donegal06/mx5-na8-ecu/boards/hellen64_NA6_94-d/board/hellen64_NA6_94-d.png

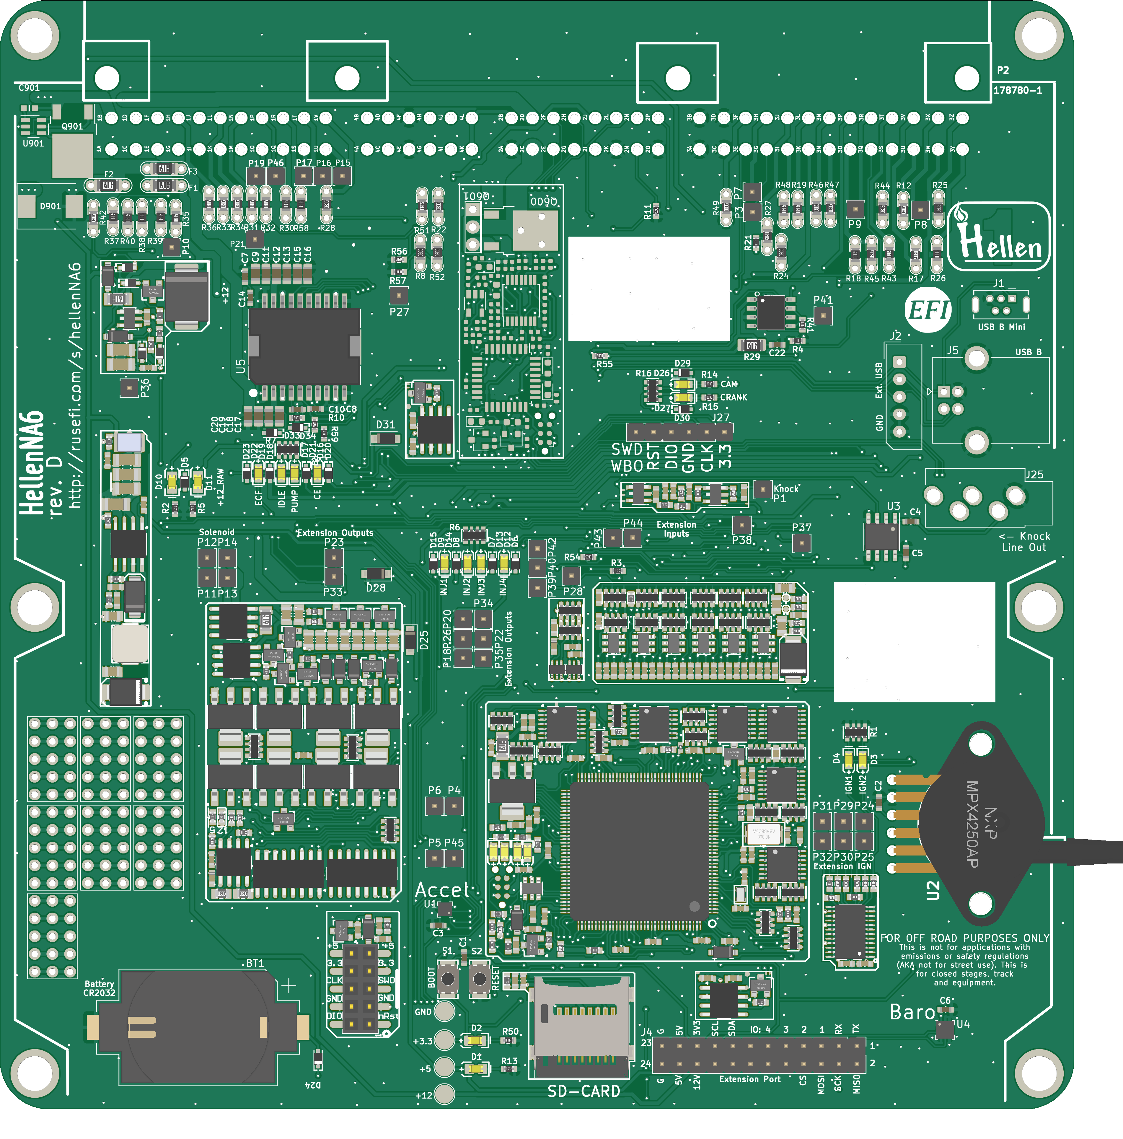
boards/hellen64_NA6_94-d/board/hellen64_NA6_94-d.png
