donegal06/mx5-na8-ecu/boards/hellen64_NA6_94-d/board/misc/hellen64_NA6_94-d-top.png

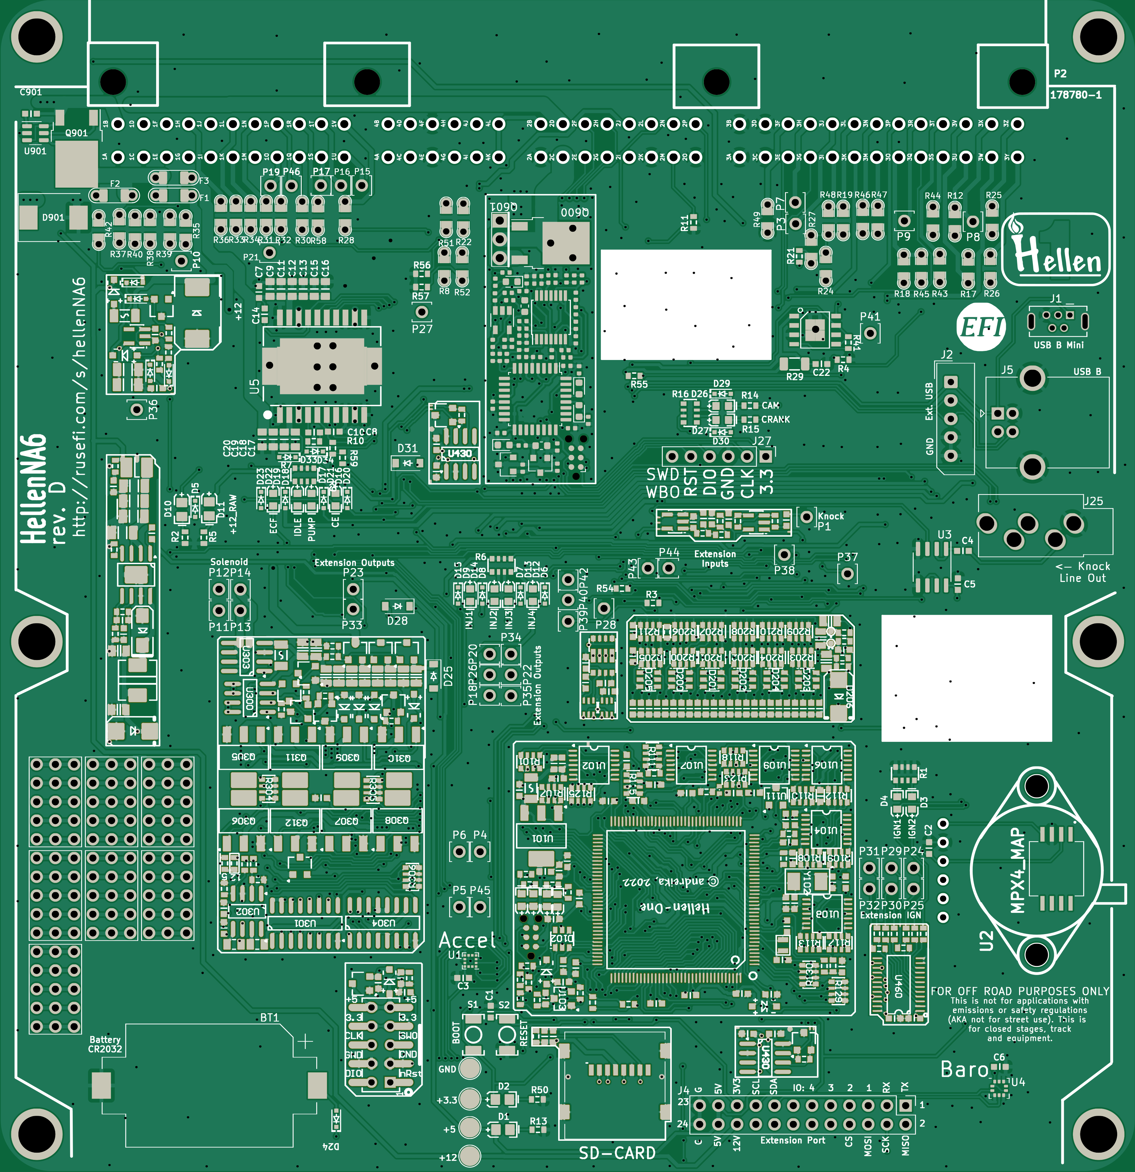
boards/hellen64_NA6_94-d/board/misc/hellen64_NA6_94-d-top.png
