donegal06/mx5-na8-ecu/tools/1b_protection_placement.png

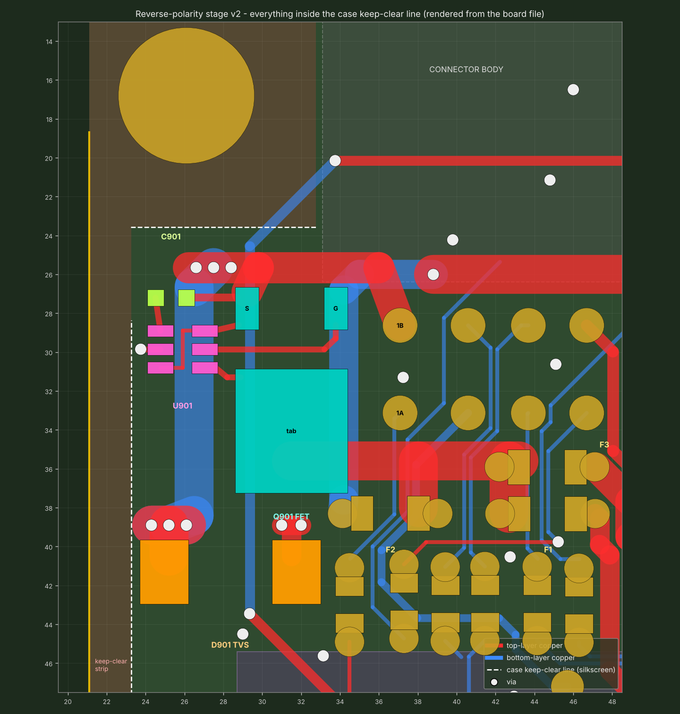
tools/1b_protection_placement.png
