donegal06/mx5-na8-ecu/bom_replace_hellen64_NA6_94-d.csv

# remove the jumper connection from VCC_PP1 to +5V: we need +12v power supply for push-pull outputs.
R309,
# remove +5V pull-ups from SPI1, because we use it with +3.3v accelerometer
R103,
R105,
# remove jumper resistor connecting BOOT1 with A22 input line, because we use STM32F4
R131,
# STM32
U105,"STM32F407ZGT6","LQFP144","C19156"
# DC-DC Inductor
L421,"MWSA0503S-100MT","SMD-5.2x5.4x2.8","C408412"
L420,"LBC3225T2R2MR","1210","C223413"
# LMR14020->LMR16030 (MX-5 fork): 60 V input rating so a load dump that gets past
# the TVS (clamp up to 53.3 V) does not exceed the buck's VIN rating.
# Pin-compatible SO-8 PowerPAD (BOOT,VIN,EN,RT,FB,SS,GND,SW), same 0.75 V FB
# reference (68k/12k divider still gives 5.0 V), same RT curve (10k = ~2.2 MHz).
# Above ~25 V input it pulse-skips (90 ns min on-time) - acceptable for transients.
U420,"LMR16030SDDA","SOP8","C882387"
# Catch diode SS34 (40 V) -> SS310 (100 V), required with the 60 V buck
D420,"SS310","SMA","C116705"
# Input TVS SMCJ30A -> SMCJ33A: VBR min 36.7 V, so it no longer conducts against an
# alternator clamped at 35 V (ISO 16750-2 pulse 5b); simulation showed SMCJ30A at
# its 33.3 V minimum absorbing ~11 J there. Vc max 53.3 V @ 28 A, within the 60 V buck.
D418,"SMCJ33A","SMC","C438109"
# Ignition outputs to the stock NA igniter (1G via R467 = IGN1, 1H via R464 = IGN2):
# 10 ohm -> 330 ohm (MX-5 fork). Matches the proven MegaSquirt drive for factory Miata
# igniters (270-330 ohm series) and limits a short to +14 V to ~39 mA, inside the
# SN74LVC4245's ~50 mA output limit. In a sustained short the 0603 overheats and opens
# first, protecting the buffer. IGN3-8 stay 10 ohm for future smart coils.
R467,"330","R0603","C23138"
R464,"330","R0603","C23138"
# CAN termination (MX-5 fork): the MCU CAN module and the wideband CAN module
# each carry a 120R terminator on the same bus, so the board measures 60R.
# Drop one so the ECU end is 120R; the last gauge pod on the bus carries the
# other 120R. Bus: ECU 1D/1F -> pod 1 -> pod 2 (terminated).
R430_2,
# trigger schmidt buffer
U490,"SN74LVC2G17DCKR","SOT-363","C50714"
U491,"SN74LVC2G17DCKR","SOT-363","C50714"
#fuses
# Logic-supply PTC (0.5 A hold, 24 V) -> 0 ohm link (MX-5 fork): the logic feed draws
# ~0.52 A at a 6.5 V crank, above the PTC's derated hold current, so a long hot crank
# could reset the ECU. Overcurrent protection stays with board fuses F1-F3 (5 A).
F410,"0R","F1206","C17888"
F300,"nSMD050-24V","F1206","C70076"
F1,"Fuse-5A-1206","F1206","C553924"
F2,"Fuse-5A-1206","F1206","C553924"
F3,"Fuse-5A-1206","F1206","C553924"
"R29,F101","nSMD035-16V","SMD1206","C70072"
#INJ low-side
Q305,"ZXMS6005SGTA","SOT-223","C174042"
Q306,"ZXMS6005SGTA","SOT-223","C174042"
Q307,"ZXMS6005SGTA","SOT-223","C174042"
Q308,"ZXMS6005SGTA","SOT-223","C174042"
Q309,"ZXMS6005SGTA","SOT-223","C174042"
Q310,"ZXMS6005SGTA","SOT-223","C174042"
Q311,"ZXMS6005SGTA","SOT-223","C174042"
Q312,"ZXMS6005SGTA","SOT-223","C174042"
#power distribution
U103,"AP2331W-7","SOT-23","C460346"
U480,"AP2331W-7","SOT-23","C460346"
#wbo opamp
U601,"GS8551-TR","TSOT23-5","C157715"
#non-JLC componentts
#WBO heater low-side (MX-5 fork: fitted, so the on-board wideband works)
Q600,"BTS3028SDL","DPAK","C2150071"
Q600_2,
#WBO low-side
Q601,
Q601_2,
#WBO STM32 (MX-5 fork: fitted; needs one-time SWD flash via J27)
U602,"STM32F042K6Tx","LQFP32","C69216"
U602_2,
#pressure sensor
U4,
#MX-5 fork: leave the optional high-side / push-pull / solenoid H-bridge outputs unfitted.
# They only reach solder pads P11-P14, P18, P22, P23, P26, P27 (not the ECU connector), nothing
# in the NA8 plan uses them, and RZ7899 / PJM2319PSA are not orderable through JLC right now.
U300,
U303,
Q300,
Q301,
Q302,
Q303,
Q304,
Q313,
Q314,
#MX-5 fork: in-stock equivalents chosen on the JLC parts page (originals out of stock)
C603,"33n","C0402","C106862"
D3,"LED-BLUE-0603","LED-0603","C138541"
D4,"LED-BLUE-0603","LED-0603","C138541"
D105,"LED-BLUE-0603","LED-0603","C138541"
D602,"LED-BLUE-0603","LED-0603","C138541"
D104,"LED-GREEN-0603","LED-0603","C19273151"
D601,"LED-GREEN-0603","LED-0603","C19273151"
D106,"LED-YELLOW-0603","LED-0603","C165981"
C227,"2.2u","C0805","C125847"
C228,"2.2u","C0805","C125847"
C229,"2.2u","C0805","C125847"
#main ECU connector (MX-5 fork): through-hole, fitted by JLC so it needn't be hand-soldered
P2,"178780-1","178780-1","C5166246"
#include board_id_na6_94-d.csv
