donegal06/mx5-na8-ecu/boards/hellen64_NA6_94-d/frame/64_NA6_94-BOM.csv

Comment | Designator | Footprint | LCSC Part #
BATTERY_CR2032 | BT1 | BATTERY-2032 | C70377
100n | C1 | C0603 | C14663
100n | C2 | C0603 | C14663
100n | C3 | C0603 | C14663
10u | C4 | C0603 | C19702
100n | C5 | C0603 | C14663
100n | C6 | C0603 | C14663
100n | C7 | C0603 | C14663
6.8n | C8 | C0603 | C1631
10u | C9 | C0805 | C15850
10n | C10 | C0603 | C57112
10u | C11 | C0805 | C15850
10u | C12 | C0805 | C15850
10u | C13 | C0805 | C15850
220n | C14 | C0603 | C21120
10u | C15 | C0805 | C15850
10u | C16 | C0805 | C15850
10u | C17 | C0805 | C15850
10u | C18 | C0805 | C15850
10u | C19 | C0805 | C15850
10u | C20 | C0805 | C15850
1u | C22 | C0603 | C15849
100n | C901 | C0603 | C14663
LED-GREEN-0805 | D1 | LED-0805 | C2297
LED-GREEN-0805 | D2 | LED-0805 | C2297
LED-BLUE-0603 | D3 | LED-0603 | C72041
LED-BLUE-0603 | D4 | LED-0603 | C72041
1N4148WS | D5 | SOD-323 | C2128
LED-RED-0603 | D6 | LED-0603 | C2286
LED-RED-0603 | D7 | LED-0603 | C2286
LED-RED-0603 | D8 | LED-0603 | C2286
LED-RED-0603 | D9 | LED-0603 | C2286
LED-GREEN-0805 | D10 | LED-0805 | C2297
LED-GREEN-0805 | D11 | LED-0805 | C2297
1N4148WS | D12 | SOD-323 | C2128
1N4148WS | D13 | SOD-323 | C2128
1N4148WS | D14 | SOD-323 | C2128
1N4148WS | D15 | SOD-323 | C2128
LED-WHITE-0603 | D16 | LED-0603 | C2290
LED-WHITE-0603 | D17 | LED-0603 | C2290
LED-WHITE-0603 | D18 | LED-0603 | C2290
LED-WHITE-0603 | D19 | LED-0603 | C2290
1N4148WS | D20 | SOD-323 | C2128
1N4148WS | D21 | SOD-323 | C2128
1N4148WS | D22 | SOD-323 | C2128
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
Jumper-Pad-Pad | R37 | PAD-0805-PAD | C17477
Jumper-Pad-Pad | R38 | PAD-0805-PAD | C17477
Jumper-Pad-Pad | R39 | PAD-0805-PAD | C17477
Jumper-Pad-Pad | R40 | PAD-0805-PAD | C17477
4.7k | R41 | R0603 | C23162
Jumper-Pad-Pad | R42 | PAD-0805-PAD | C17477
Jumper-Pad-Pad | R43 | PAD-0805-PAD | C17477
Jumper-Pad-Pad | R44 | PAD-0805-PAD | C17477
Jumper-Pad-Pad | R45 | PAD-0805-PAD | C17477
Jumper-Pad-Pad | R46 | PAD-0805-PAD | C17477
Jumper-Pad-Pad | R47 | PAD-0805-PAD | C17477
Jumper-Pad-Pad | R48 | PAD-0805-PAD | C17477
Jumper-Pad-Pad | R49 | PAD-0805-PAD | C17477
750 | R50 | R0603 | C23241
Jumper-Pad-Pad | R51 | PAD-0805-PAD | C17477
Jumper-Pad-Pad | R52 | PAD-0805-PAD | C17477
2.7k | R54 | R0603 | C13167
2.7k | R55 | R0603 | C13167
680k | R56 | R0603 | C25822
680k | R57 | R0603 | C25822
Jumper-Pad-Pad | R58 | PAD-0805-PAD | C17477
10k | R59 | R0603 | C25804
Button_SPST | S1 | SMD-2_2.9x3.9x1.7 | C115357
Button_SPST | S2 | SMD-2_2.9x3.9x1.7 | C115357
LIS2DW12TR | U1 | LGA-12_2x2mm_P0.5mm | C189624
MPX4_MAP | U2 | MPX-4_MAP
MCP6002-xSN | U3 | SO8 | C7377
LPS25HB | U4 | HLGA-10 | C87898
L6205PD | U5 | SO20POWER | C36543
TLS115 | U6 | PG-DSO-8-43 | C540242
MPXH6400A | U7 | MPXH6400A-SSOP8 | C511770
LM74700QDBVRQ1 | U901 | SOT23-6 | C2941042
