donegal06/mx5-na8-ecu/hellen64_NA6_94.kicad_pcb

## KiCad design hellen64_NA6_94.kicad_pcb (2026-11-13)

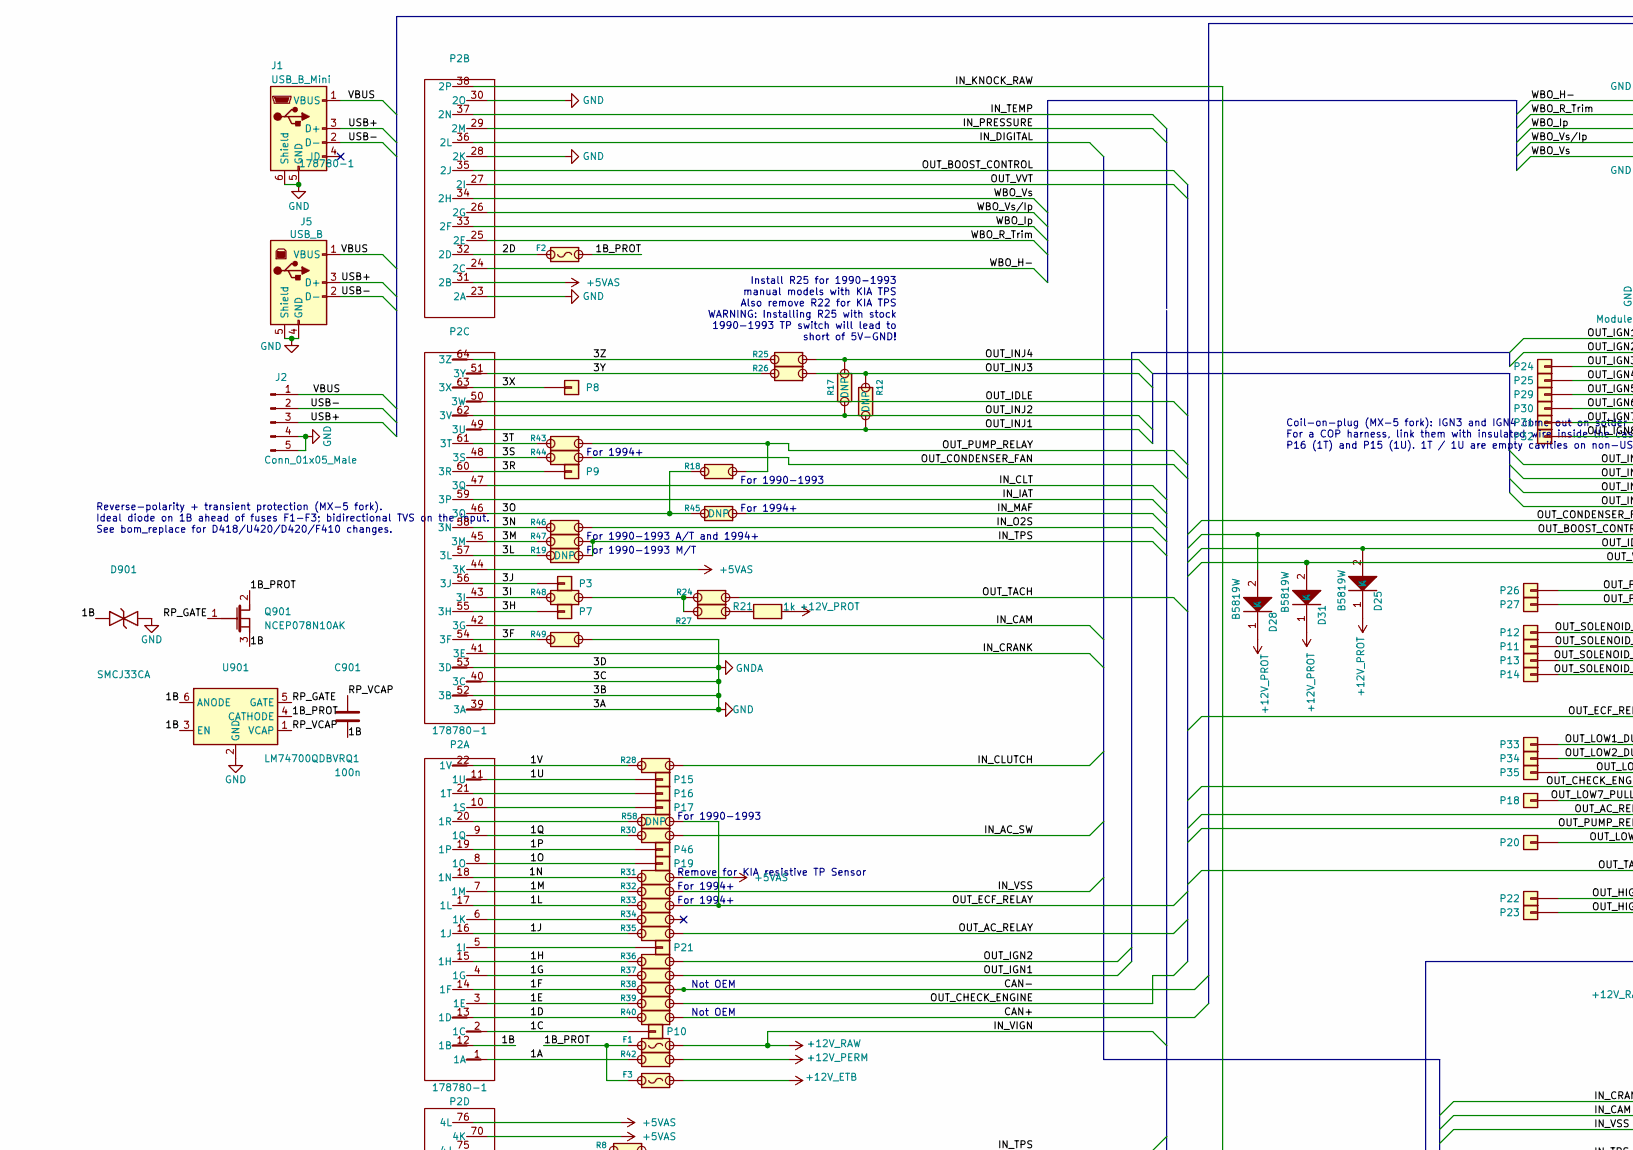
[picture p6: schematic hellen64_NA6_94.kicad_sch, hellen64 NA6 94, part in row 1, column 1]

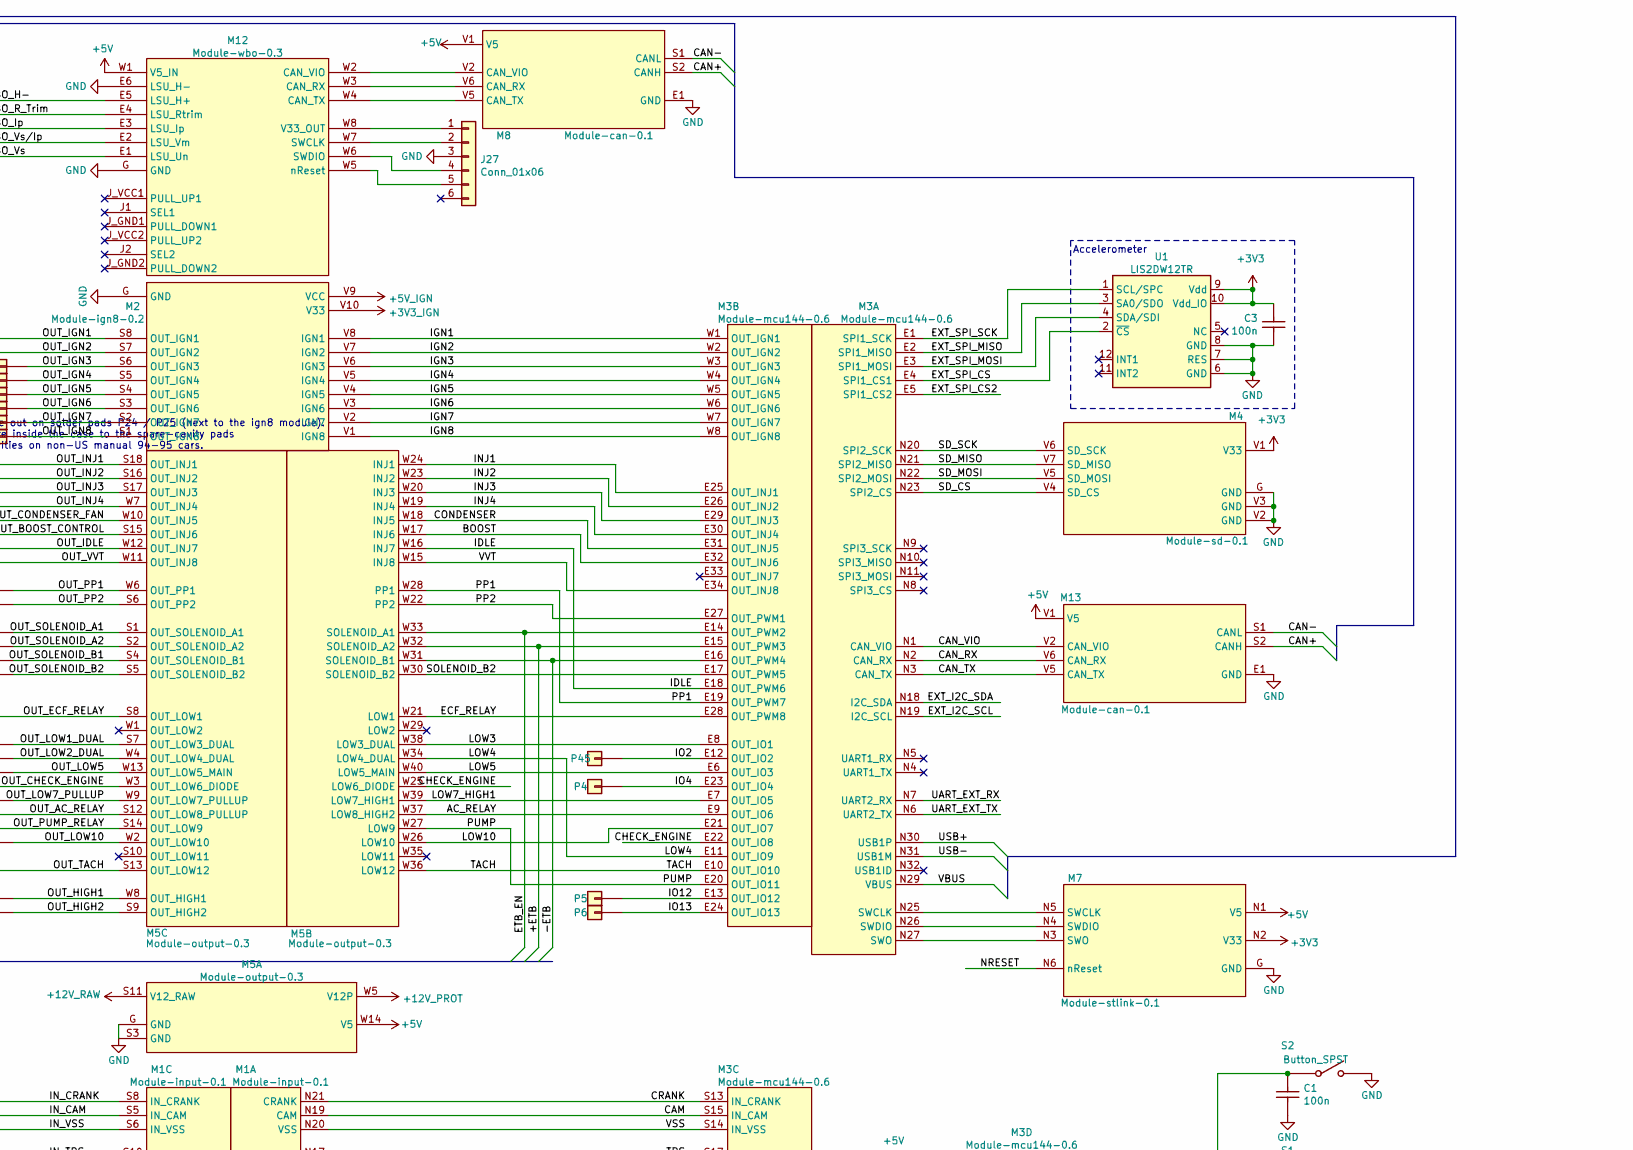
[picture p7: schematic hellen64_NA6_94.kicad_sch, hellen64 NA6 94, part in row 1, column 2]

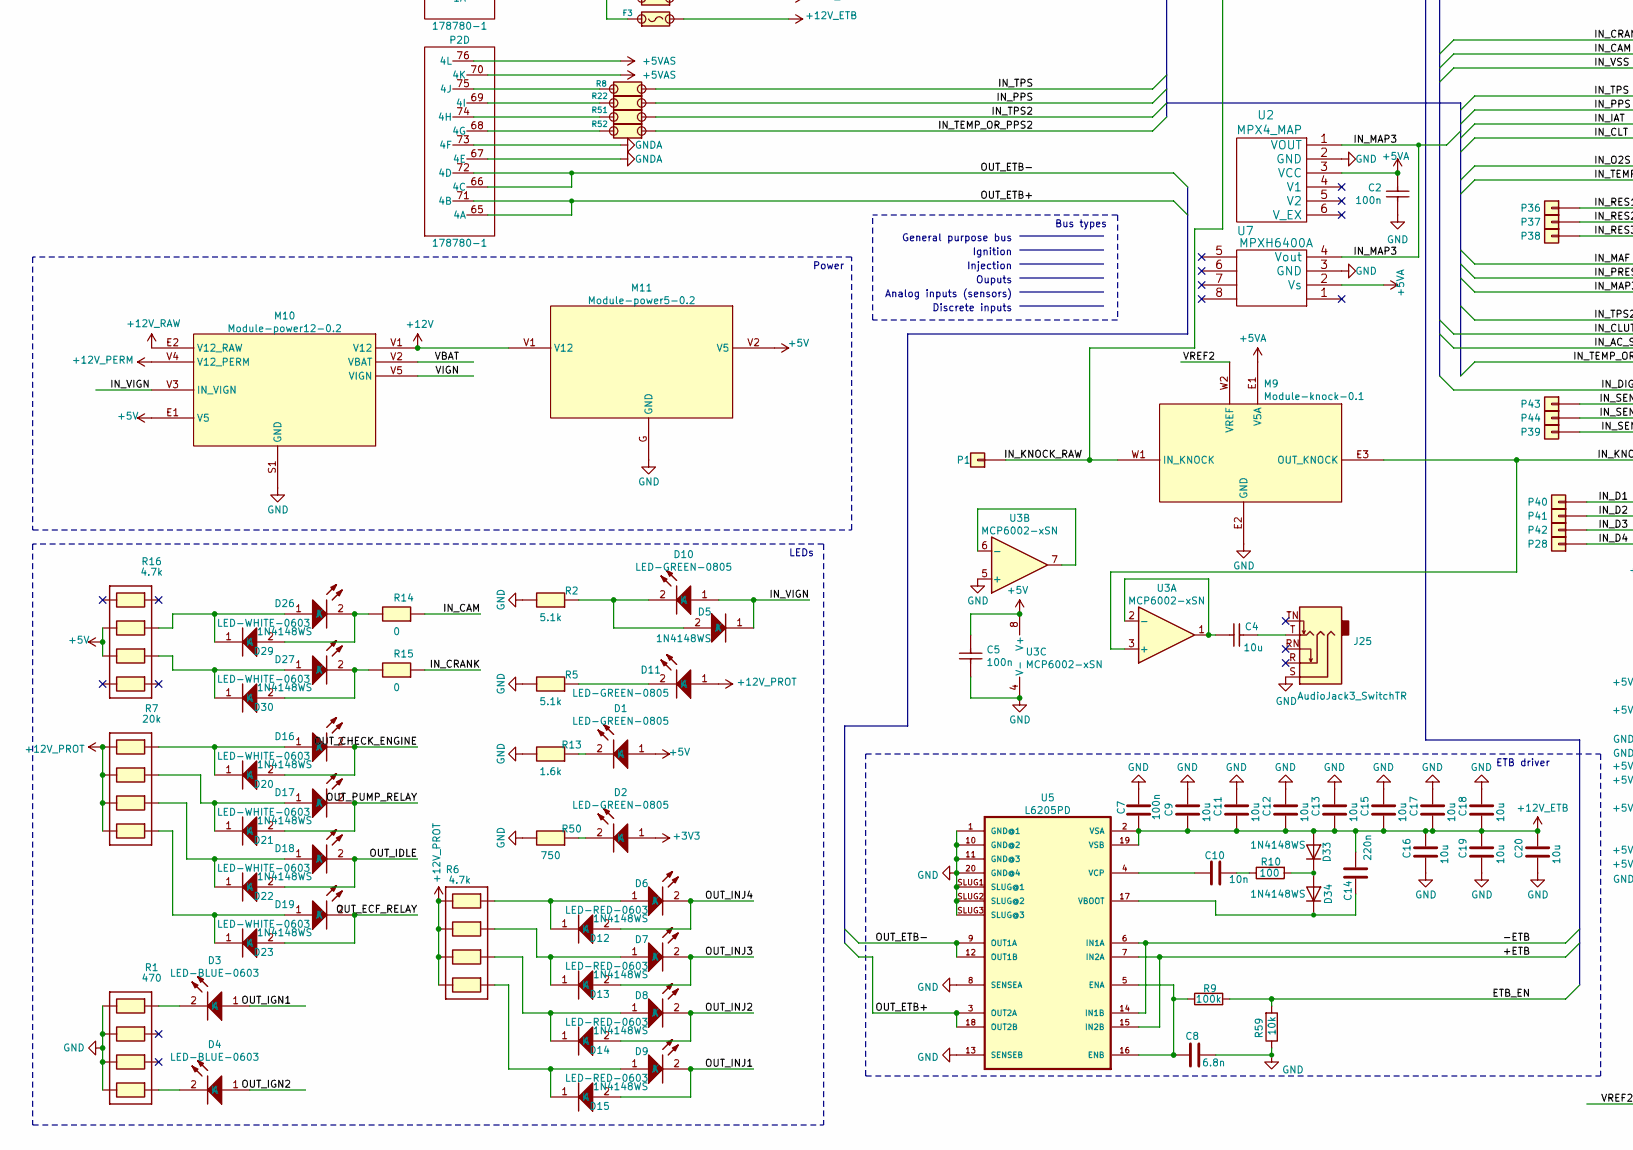
[picture p8: schematic hellen64_NA6_94.kicad_sch, hellen64 NA6 94, part in row 2, column 1]

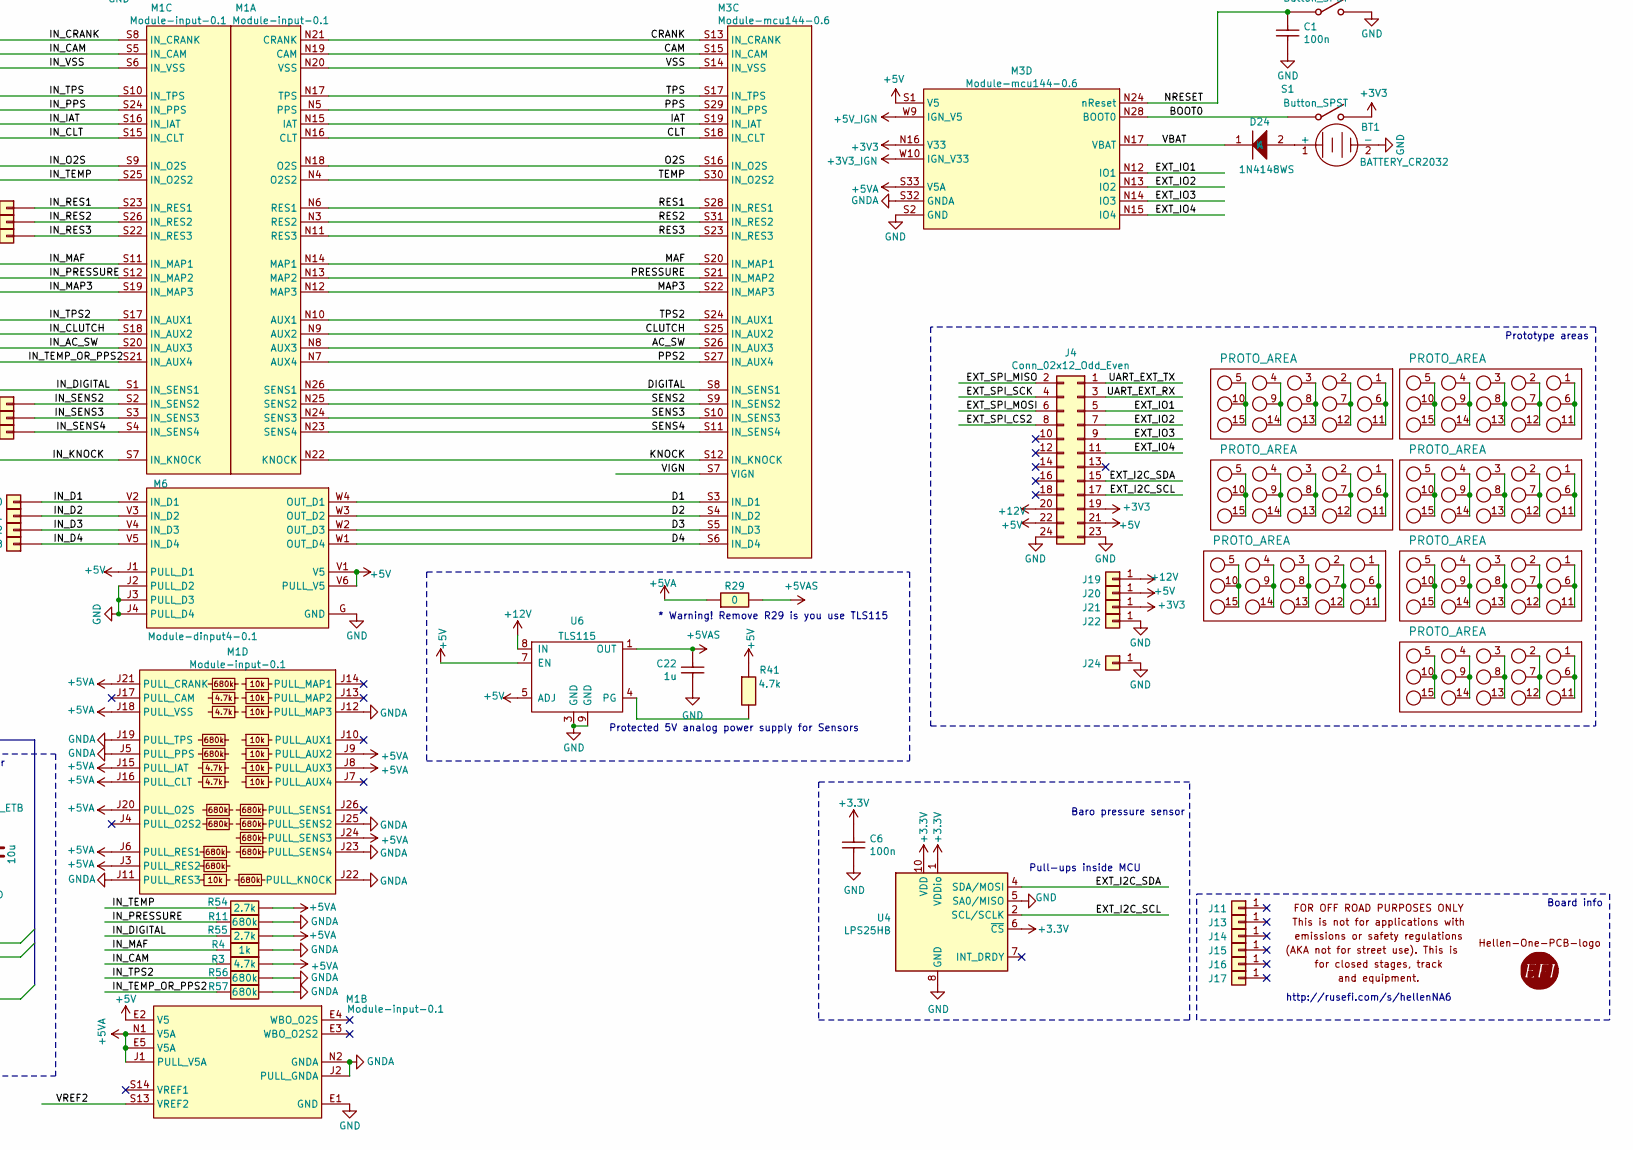
[picture p9: schematic hellen64_NA6_94.kicad_sch, hellen64 NA6 94, part in row 2, column 2]

Parts:
BT1: BATTERY_CR2032; BatteryHolder_Keystone_1060_1x2032; LCSC C70377
C1, C2, C3, C5, C6, C7, C901: 100n; C0603; LCSC C14663
C4: 10u; C0603; LCSC C19702
C8: 6.8n; C0603; LCSC C1631
C9, C11, C12, C13, C15, C16, C17, C18, C19, C20: 10u; C0805; LCSC C15850
C10: 10n; C0603; LCSC C57112
C14: 220n; C0603; LCSC C21120
C22: 1u; C0603; LCSC C15849
D1, D2, D10, D11: LED-GREEN-0805; LED-0805; LCSC C2297
D3, D4: LED-BLUE-0603; LED-0603; LCSC C72041
D5, D12, D13, D14, D15, D20, D21, D22, D23, D24, D29, D30, D33, D34: 1N4148WS; SOD-323; LCSC C2128
D6, D7, D8, D9: LED-RED-0603; LED-0603; LCSC C2286
D16, D17, D18, D19, D26, D27: LED-WHITE-0603; LED-0603; LCSC C2290
D25, D28, D31: B5819W; SOD-123; LCSC C8598
D901: SMCJ33CA; D_SMC; LCSC C699040
F1, F2, F3: Fuse-Pad-Pad; PAD-1206-PAD; LCSC C182446
G1, G3: LOGO
G2: DISCLAIMER; Off_Road_Disclaimer
G4, G5, G6, G7, G9, G11, G12: PROTO_AREA
J1: USB_B_Mini; USB-MINI-B-VERTICAL; LCSC C13453
J2: Conn_01x05_Male; Molex_SPOX_5267-05A_1x05_P2.50mm_Vertical
J4: Conn_02x12_Odd_Even; PinHeader_2x12_P2.54mm_Vertical
J5: USB_B; LCSC C46392
J11, J13, J14, J15, J16, J17: Conn_01x01; MountingHole_4.5mm_Pad
J19, J20, J21, J22, J24: Conn_01x01; TestPoint_Pad_D2.0mm
J25: AudioJack3_SwitchTR; Jack_3.5mm_PJ-3250-5A; LCSC C165947
J27: Conn_01x06; PinHeader_1x06_P2.54mm_Vertical
M1: Module-input-0.1; input
M2: Module-ign8-0.2; ign8
M3: Module-mcu144-0.6; mcu
M4: Module-sd-0.1; sd
M5: Module-output-0.3; output
M6: Module-dinput4-0.1; dinput4
M7: Module-stlink-0.1; stlink
M8, M13: Module-can-0.1; can
M9: Module-knock-0.1; knock
M10: Module-power12-0.2; power12
M11: Module-power5-0.2; power5
M12: Module-wbo-0.3; wbo
P1, P3, P4, P5, P6, P7, P8, P9, P10, P11, P12, P13, P14, P15, P16, P17, P18, P19, P20, P21, P22, P23, P24, P25, P26, P27, P28, P29, P30, P31, P32, P33, P34, P35, P36, P37, P38, P39, P40, P41, P42, P43, P44, P45, P46: Pad; PAD-TH
P2: 178780-1
Q901: NCEP078N10AK; TO-252-2; LCSC C2686699
R1: 470; R0603-4; LCSC C25510
R2, R5: 5.1k; R0603; LCSC C23186
R3, R41: 4.7k; R0603; LCSC C23162
R4, R21: 1k; R0603; LCSC C21190
R6, R16: 4.7k; R0603-4; LCSC C1980
R7: 20k; R0603-4; LCSC C12004
R8, R18, R22, R24, R25, R26, R27, R28, R30, R31, R32, R33, R34, R35, R36, R37, R38, R39, R40, R42, R43, R44, R46, R47, R48, R49, R51, R52: Jumper-Pad-Pad; PAD-0805-PAD; LCSC C17477
R9: 100k; R0603; LCSC C25803
R10: 100; R0603; LCSC C22775
R11, R56, R57: 680k; R0603; LCSC C25822
R12, R17, R19, R45, R58: Jumper-Pad-Pad; PAD-0805-PAD
R13: 1.6k; R0603; LCSC C22847
R14, R15: 0; R0603; LCSC C21189
R29: SMD1206B035TF/16; R1206; LCSC C269114
R50: 750; R0603; LCSC C23241
R54, R55: 2.7k; R0603; LCSC C13167
R59: 10k; R0603; LCSC C25804
S1, S2: Button_SPST; SMD-2_2.9x3.9x1.7; LCSC C115357
U1: LIS2DW12TR; LGA-12_2x2mm_P0.5mm; LCSC C189624
U2: MPX4_MAP; MPX-4_MAP
U3: MCP6002-xSN; SOIC-8_3.9x4.9mm_P1.27mm; LCSC C7377
U4: LPS25HB; ST_HLGA-10_2.5x2.5mm_P0.6mm_LayoutBorder3x2y; LCSC C87898
U5: L6205PD; SO20POWER; LCSC C36543
U6: TLS115; PG-DSO-8-43; LCSC C540242
U7: MPXH6400A; MPXH6400A-SSOP8; LCSC C511770
U901: LM74700QDBVRQ1; SOT-23-6; LCSC C2941042

Connections:
+3V3_IGN: M2.V10 (V33), M3.W10 (IGN_V33)
+5V: C5.2, D1.1 (A), J4.21, J4.22, J20.1, M1.E2 (V5), M3.S1 (V5), M5.W14 (V5), M6.J1 (PULL_D1), M6.V1 (V5), M6.V6 (PULL_V5), M7.N1 (V5), M8.V1 (V5), M10.E1 (V5), M11.V2 (V5), M12.W1 (V5_IN), M13.V1 (V5), R16.2, R16.3, R41.1, U3.8 (V+), U6.5 (ADJ), U6.7 (EN)
+5VA: C2.2, M1.E5 (V5A), M1.J1 (PULL_V5A), M1.J3 (PULL_RES2), M1.J6 (PULL_RES1), M1.J8 (PULL_AUX3), M1.J9 (PULL_AUX2), M1.J15 (PULL_IAT), M1.J16 (PULL_CLT), M1.J18 (PULL_VSS), M1.J20 (PULL_O2S), M1.J21 (PULL_CRANK), M1.J24 (PULL_SENS3), M1.N1 (V5A), M3.S33 (V5A), M9.E1 (V5A), R3.1, R29.1, R54.2, R55.2, U2.3 (VCC), U7.2 (Vs)
+5VAS: C22.2, P2.31 (2B), P2.44 (3K), P2.70 (4K), P2.76 (4L), R29.2, R31.1, U6.1 (OUT)
+5V_IGN: M2.V9 (VCC), M3.W9 (IGN_V5)
+12V: J4.20, J19.1, M10.V1 (V12), M11.V1 (V12), U6.8 (IN)
+12V_ETB: C7.2, C9.1, C11.1, C12.1, C13.1, C14.1, C15.1, C16.2, C17.1, C18.1, C19.2, C20.2, D33.2 (A), F3.2, U5.2 (VSA), U5.19 (VSB)
+12V_PERM: M10.V4 (V12_PERM), R42.1
+12V_PROT: D11.1 (A), D25.1 (K), D28.1 (K), D31.1 (K), M5.W5 (V12P), R6.1, R6.2, R6.3, R6.4, R7.1, R7.2, R7.3, R7.4, R21.1
+12V_RAW: D5.1 (K), D10.1 (A), F1.2, M5.S11 (V12_RAW), M10.E2 (V12_RAW), M10.V3 (IN_VIGN)
/1A: P2.1 (1A), R42.2
/1B: C901.2, D901.1 (A1), P2.12 (1B), Q901.3 (S), U901.3 (EN), U901.6 (ANODE)
/1B_PROT: F1.1, F2.2, F3.1, Q901.2 (D), U901.4 (CATHODE)
/1C: P2.2 (1C), P10.1
/1D: P2.13 (1D), R40.2
/1E: P2.3 (1E), R39.2
/1F: P2.14 (1F), R38.2
/1G: P2.4 (1G), R37.2
/1H: P2.15 (1H), R36.2
/1J: P2.16 (1J), R35.2
/1L: P2.17 (1L), R33.2
/1M: P2.7 (1M), R32.2
/1N: P2.18 (1N), R31.2
/1O: P2.8 (1O), P19.1
/1P: P2.19 (1P), P46.1
/1Q: P2.9 (1Q), R30.2
/1U: P2.11 (1U), P15.1
/1V: P2.22 (1V), R28.2
/2D: F2.1, P2.32 (2D)
/3F: P2.54 (3F), R49.2
/3H: P2.55 (3H), P7.1
/3I: P2.43 (3I), R48.2
/3J: P2.56 (3J), P3.1
/3L: P2.57 (3L), R19.2
/3M: P2.45 (3M), R47.2
/3N: P2.58 (3N), R46.2
/3O: P2.46 (3O), R18.2, R45.2
/3R: P2.60 (3R), P9.1
/3S: P2.48 (3S), R44.2
/3T: P2.61 (3T), R43.2
/3X: P2.63 (3X), P8.1
/3Y: P2.51 (3Y), R26.2
/3Z: P2.64 (3Z), R25.2
/+ETB: M3.E15 (OUT_PWM3), M5.W32 (SOLENOID_A2), U5.7 (IN2A), U5.15 (IN2B)
/-ETB: M3.E16 (OUT_PWM4), M5.W31 (SOLENOID_B1), U5.6 (IN1A), U5.14 (IN1B)
/AC_RELAY: M3.E9 (OUT_IO6), M5.W37 (LOW8_HIGH2)
/AC_SW: M1.N8 (AUX3), M3.S26 (IN_AUX3)
/BOOST: M3.E32 (OUT_INJ6), M5.W17 (INJ6)
/BOOT0: M3.N28 (BOOT0), S1.1
/CAM: M1.N19 (CAM), M3.S15 (IN_CAM)
/CAN+: M8.S2 (CANH), M13.S2 (CANH), R40.1
/CAN-: M8.S1 (CANL), M13.S1 (CANL), R38.1
/CAN_RX: M3.N2 (CAN_RX), M13.V6 (CAN_RX)
/CAN_TX: M3.N3 (CAN_TX), M13.V5 (CAN_TX)
/CAN_VIO: M3.N1 (CAN_VIO), M13.V2 (CAN_VIO)
/CHECK_ENGINE: M3.E22 (OUT_IO8), M5.W25 (LOW6_DIODE)
/CLT: M1.N16 (CLT), M3.S18 (IN_CLT)
/CLUTCH: M1.N9 (AUX2), M3.S25 (IN_AUX2)
/CONDENSER: M3.E31 (OUT_INJ5), M5.W18 (INJ5)
/CRANK: M1.N21 (CRANK), M3.S13 (IN_CRANK)
/D1: M3.S3 (IN_D1), M6.W4 (OUT_D1)
/D2: M3.S4 (IN_D2), M6.W3 (OUT_D2)
/D3: M3.S5 (IN_D3), M6.W2 (OUT_D3)
/D4: M3.S6 (IN_D4), M6.W1 (OUT_D4)
/DIGITAL: M1.N26 (SENS1), M3.S8 (IN_SENS1)
/ECF_RELAY: M3.E28 (OUT_PWM8), M5.W21 (LOW1)
/ETB_EN: M3.E14 (OUT_PWM2), M5.W33 (SOLENOID_A1), R9.2, R59.2
/EXT_I2C_SCL: J4.17, M3.N19 (I2C_SCL), U4.2 (SCL/SCLK)
/EXT_I2C_SDA: J4.15, M3.N18 (I2C_SDA), U4.4 (SDA/MOSI)
/EXT_IO1: J4.5, M3.N12 (IO1)
/EXT_IO2: J4.7, M3.N13 (IO2)
/EXT_IO3: J4.9, M3.N14 (IO3)
/EXT_IO4: J4.11, M3.N15 (IO4)
/EXT_SPI_CS: M3.E4 (SPI1_CS1), U1.2 (~CS)
/EXT_SPI_CS2: J4.8, M3.E5 (SPI1_CS2)
/EXT_SPI_MISO: J4.2, M3.E2 (SPI1_MISO), U1.3 (SA0/SDO)
/EXT_SPI_MOSI: J4.6, M3.E3 (SPI1_MOSI), U1.4 (SDA/SDI)
/EXT_SPI_SCK: J4.4, M3.E1 (SPI1_SCK), U1.1 (SCL/SPC)
/IAT: M1.N15 (IAT), M3.S19 (IN_IAT)
/IDLE: M3.E18 (OUT_PWM6), M5.W16 (INJ7)
/IGN1: M2.V8 (IGN1), M3.W1 (OUT_IGN1)
/IGN2: M2.V7 (IGN2), M3.W2 (OUT_IGN2)
/IGN3: M2.V6 (IGN3), M3.W3 (OUT_IGN3)
/IGN4: M2.V5 (IGN4), M3.W4 (OUT_IGN4)
/IGN5: M2.V4 (IGN5), M3.W5 (OUT_IGN5)
/IGN6: M2.V3 (IGN6), M3.W6 (OUT_IGN6)
/IGN7: M2.V2 (IGN7), M3.W7 (OUT_IGN7)
/IGN8: M2.V1 (IGN8), M3.W8 (OUT_IGN8)
/INJ1: M3.E25 (OUT_INJ1), M5.W24 (INJ1)
/INJ2: M3.E26 (OUT_INJ2), M5.W23 (INJ2)
/INJ3: M3.E29 (OUT_INJ3), M5.W20 (INJ3)
/INJ4: M3.E30 (OUT_INJ4), M5.W19 (INJ4)
/IN_AC_SW: M1.S20 (IN_AUX3), R30.1
/IN_CAM: M1.S5 (IN_CAM), P2.42 (3G), R3.2, R14.1
/IN_CLT: M1.S15 (IN_CLT), P2.47 (3Q)
/IN_CLUTCH: M1.S18 (IN_AUX2), R28.1
/IN_CRANK: M1.S8 (IN_CRANK), P2.41 (3E), R15.1
/IN_D1: M6.V2 (IN_D1), P40.1
/IN_D2: M6.V3 (IN_D2), P41.1
/IN_D3: M6.V4 (IN_D3), P42.1
/IN_D4: M6.V5 (IN_D4), P28.1
/IN_DIGITAL: M1.S1 (IN_SENS1), P2.36 (2L), R55.1
/IN_IAT: M1.S16 (IN_IAT), P2.59 (3P)
/IN_KNOCK: M1.S7 (IN_KNOCK), M9.E3 (OUT_KNOCK), U3.3 (+)
/IN_KNOCK_RAW: M9.W1 (IN_KNOCK), P1.1, P2.38 (2P)
/IN_MAF: M1.S11 (IN_MAP1), R4.1, R45.1
/IN_MAP3: M1.S19 (IN_MAP3), U2.1 (VOUT), U7.4 (Vout)
/IN_O2S: M1.S9 (IN_O2S), R46.1
/IN_PPS: M1.S24 (IN_PPS), R22.1
/IN_PRESSURE: M1.S12 (IN_MAP2), P2.29 (2M), R11.1
/IN_RES1: M1.S23 (IN_RES1), P36.1
/IN_RES2: M1.S26 (IN_RES2), P37.1
/IN_RES3: M1.S22 (IN_RES3), P38.1
/IN_SENS2: M1.S2 (IN_SENS2), P43.1
/IN_SENS3: M1.S3 (IN_SENS3), P44.1
/IN_SENS4: M1.S4 (IN_SENS4), P39.1
/IN_TEMP: M1.S25 (IN_O2S2), P2.37 (2N), R54.1
/IN_TEMP_OR_PPS2: M1.S21 (IN_AUX4), R52.1, R57.1
/IN_TPS: M1.S10 (IN_TPS), R8.1, R19.1, R47.1
/IN_TPS2: M1.S17 (IN_AUX1), R51.1, R56.1
/IN_VSS: M1.S6 (IN_VSS), R32.1
/IO2: M3.E12 (OUT_IO2), P45.1
/IO4: M3.E23 (OUT_IO4), P4.1
/IO12: M3.E13 (OUT_IO12), P5.1
/IO13: M3.E24 (OUT_IO13), P6.1
/KNOCK: M1.N22 (KNOCK), M3.S12 (IN_KNOCK)
/LOW3: M3.E8 (OUT_IO1), M5.W38 (LOW3_DUAL)
/LOW4: M3.E11 (OUT_IO9), M5.W34 (LOW4_DUAL)
/LOW5: M3.E6 (OUT_IO3), M5.W40 (LOW5_MAIN)
/LOW7_HIGH1: M3.E7 (OUT_IO5), M5.W39 (LOW7_HIGH1)
/LOW10: M3.E21 (OUT_IO7), M5.W26 (LOW10)
/MAF: M1.N14 (MAP1), M3.S20 (IN_MAP1)
/MAP3: M1.N12 (MAP3), M3.S22 (IN_MAP3)
/NRESET: C1.2, M3.N24 (nReset), M7.N6 (nReset), S2.1
/O2S: M1.N18 (O2S), M3.S16 (IN_O2S)
/OUT_AC_RELAY: M5.S12 (OUT_LOW8_PULLUP), R35.1
/OUT_BOOST_CONTROL: D28.2 (A), M5.S15 (OUT_INJ6), P2.35 (2J)
/OUT_CHECK_ENGINE: D16.2 (K), D20.2 (A), M5.W3 (OUT_LOW6_DIODE), R39.1
/OUT_CONDENSER_FAN: M5.W10 (OUT_INJ5), R44.1
/OUT_ECF_RELAY: D19.2 (K), D23.2 (A), M5.S8 (OUT_LOW1), R33.1, R58.1
/OUT_ETB+: P2.65 (4A), P2.71 (4B), U5.3 (OUT2A), U5.18 (OUT2B)
/OUT_ETB-: P2.66 (4C), P2.72 (4D), U5.9 (OUT1A), U5.12 (OUT1B)
/OUT_HIGH1: M5.W8 (OUT_HIGH1), P22.1
/OUT_HIGH2: M5.S9 (OUT_HIGH2), P23.1
/OUT_IDLE: D18.2 (K), D22.2 (A), D25.2 (A), M5.W12 (OUT_INJ7), P2.50 (3W)
/OUT_IGN1: D3.1 (A), M2.S8 (OUT_IGN1), R37.1
/OUT_IGN2: D4.1 (A), M2.S7 (OUT_IGN2), R36.1
/OUT_IGN3: M2.S6 (OUT_IGN3), P24.1
/OUT_IGN4: M2.S5 (OUT_IGN4), P25.1
/OUT_IGN5: M2.S4 (OUT_IGN5), P29.1
/OUT_IGN6: M2.S3 (OUT_IGN6), P30.1
/OUT_IGN7: M2.S2 (OUT_IGN7), P31.1
/OUT_IGN8: M2.S1 (OUT_IGN8), P32.1
/OUT_INJ1: D9.2 (K), D15.2 (A), M5.S18 (OUT_INJ1), P2.49 (3U), R12.2
/OUT_INJ2: D8.2 (K), D14.2 (A), M5.S16 (OUT_INJ2), P2.62 (3V), R17.2
/OUT_INJ3: D7.2 (K), D13.2 (A), M5.S17 (OUT_INJ3), R12.1, R26.1
/OUT_INJ4: D6.2 (K), D12.2 (A), M5.W7 (OUT_INJ4), R17.1, R25.1
/OUT_LOW1_DUAL: M5.S7 (OUT_LOW3_DUAL), P33.1
/OUT_LOW2_DUAL: M5.W4 (OUT_LOW4_DUAL), P34.1
/OUT_LOW5: M5.W13 (OUT_LOW5_MAIN), P35.1
/OUT_LOW7_PULLUP: M5.W9 (OUT_LOW7_PULLUP), P18.1
/OUT_LOW10: M5.W2 (OUT_LOW10), P20.1
/OUT_PP1: M5.W6 (OUT_PP1), P26.1
/OUT_PP2: M5.S6 (OUT_PP2), P27.1
/OUT_PUMP_RELAY: D17.2 (K), D21.2 (A), M5.S14 (OUT_LOW9), R18.1, R43.1
/OUT_SOLENOID_A1: M5.S1 (OUT_SOLENOID_A1), P12.1
/OUT_SOLENOID_A2: M5.S2 (OUT_SOLENOID_A2), P11.1
/OUT_SOLENOID_B1: M5.S4 (OUT_SOLENOID_B1), P13.1
/OUT_SOLENOID_B2: M5.S5 (OUT_SOLENOID_B2), P14.1
/OUT_TACH: M5.S13 (OUT_LOW12), R24.1
/OUT_VVT: D31.2 (A), M5.W11 (OUT_INJ8), P2.27 (2I)
/PP1: M3.E19 (OUT_PWM7), M5.W28 (PP1)
/PP2: M3.E27 (OUT_PWM1), M5.W22 (PP2)
/PPS: M1.N5 (PPS), M3.S29 (IN_PPS)
/PPS2: M1.N7 (AUX4), M3.S27 (IN_AUX4)
/PRESSURE: M1.N13 (MAP2), M3.S21 (IN_MAP2)
/PUMP: M3.E20 (OUT_IO11), M5.W27 (LOW9)
/RES1: M1.N6 (RES1), M3.S28 (IN_RES1)
/RES2: M1.N3 (RES2), M3.S31 (IN_RES2)
/RES3: M1.N11 (RES3), M3.S23 (IN_RES3)
/RP_GATE: Q901.1 (G), U901.5 (GATE)
/RP_VCAP: C901.1, U901.1 (VCAP)
/SD_CS: M3.N23 (SPI2_CS), M4.V4 (SD_CS)
/SD_MISO: M3.N21 (SPI2_MISO), M4.V7 (SD_MISO)
/SD_MOSI: M3.N22 (SPI2_MOSI), M4.V5 (SD_MOSI)
/SD_SCK: M3.N20 (SPI2_SCK), M4.V6 (SD_SCK)
/SENS2: M1.N25 (SENS2), M3.S9 (IN_SENS2)
/SENS3: M1.N24 (SENS3), M3.S10 (IN_SENS3)
/SENS4: M1.N23 (SENS4), M3.S11 (IN_SENS4)
/SOLENOID_B2: M3.E17 (OUT_PWM5), M5.W30 (SOLENOID_B2)
/TACH: M3.E10 (OUT_IO10), M5.W36 (LOW12)
/TEMP: M1.N4 (O2S2), M3.S30 (IN_O2S2)
/TPS: M1.N17 (TPS), M3.S17 (IN_TPS)
/TPS2: M1.N10 (AUX1), M3.S24 (IN_AUX1)
/UART_EXT_RX: J4.3, M3.N7 (UART2_RX)
/UART_EXT_TX: J4.1, M3.N6 (UART2_TX)
/USB+: J1.3 (D+), J2.3, J5.3 (D+), M3.N30 (USB1P)
/USB-: J1.2 (D-), J2.2, J5.2 (D-), M3.N31 (USB1M)
/VBAT: D24.1 (K), M3.N17 (VBAT), M10.V2 (VBAT)
/VBUS: J1.1 (VBUS), J2.1, J5.1 (VBUS), M3.N29 (VBUS)
/VIGN: M3.S7 (VIGN), M10.V5 (VIGN)
/VREF2: M1.S13 (VREF2), M9.W2 (VREF)
/VSS: M1.N20 (VSS), M3.S14 (IN_VSS)
/VVT: M3.E34 (OUT_INJ8), M5.W15 (INJ8)
/WBO_H-: M12.E5 (LSU_H+), P2.24 (2C)
/WBO_Ip: M12.E3 (LSU_Ip), P2.33 (2F)
/WBO_R_Trim: M12.E4 (LSU_Rtrim), P2.25 (2E)
/WBO_Vs: M12.E1 (LSU_Un), P2.34 (2H)
/WBO_Vs/Ip: M12.E2 (LSU_Vm), P2.26 (2G)
GND: BT1.2 (-), C1.1, C2.1, C3.1, C5.1, C6.1, C7.1, C8.2, C9.2, C11.2, C12.2, C13.2, C15.2, C16.1, C17.2, C18.2, C19.1, C20.1, C22.1, D901.2 (A2), J1.5 (GND), J1.6 (Shield), J2.4, J2.5, J4.23, J4.24, J5.4 (GND), J5.5 (Shield), J22.1, J24.1, J25.S, J27.3, M1.E1 (GND), M1.J2 (PULL_GNDA), M1.J5 (PULL_PPS), M1.J11 (PULL_RES3), M1.J12 (PULL_MAP3), M1.J19 (PULL_TPS), M1.J22 (PULL_KNOCK), M1.J23 (PULL_SENS4), M1.J25 (PULL_SENS2), M1.N2 (GNDA), M2.G (GND), M3.S2 (GND), M3.S32 (GNDA), M4.G (GND), M4.V2 (GND), M4.V3 (GND), M5.G (GND), M5.S3 (GND), M6.G (GND), M6.J2 (PULL_D2), M6.J3 (PULL_D3), M6.J4 (PULL_D4), M7.G (GND), M8.E1 (GND), M9.E2 (GND), M10.S1 (GND), M11.G (GND), M12.E6 (LSU_H-), M12.G (GND), M13.E1 (GND), P2.23 (2A), P2.28 (2K), P2.30 (2O), P2.39 (3A), P2.40 (3C), P2.52 (3B), P2.53 (3D), P2.67 (4E), P2.73 (4F), R1.1, R1.2, R1.3, R1.4, R2.2, R4.2, R5.2, R11.2, R13.2, R49.1, R50.2, R56.2, R57.2, R59.1, S2.2, U1.6 (GND), U1.7 (RES), U1.8 (GND), U2.2 (GND), U3.4 (V-), U3.5 (+), U4.3 (GND), U4.5 (SA0/MISO), U4.8 (GND), U4.9 (GND), U5.1 (GND@1), U5.8 (SENSEA), U5.10 (GND@2), U5.11 (GND@3), U5.13 (SENSEB), U5.20 (GND@4), U5.SLUG1 (SLUG@1), U5.SLUG2 (SLUG@2), U5.SLUG3 (SLUG@3), U6.3 (GND), U6.9 (GND), U7.3 (GND), U901.2 (GND)
unnamed: BT1.1 (+), D24.2 (A)
unnamed: C4.1, J25.T
unnamed: C4.2, U3.1, U3.2 (-)
unnamed: C8.1, R9.1, U5.5 (ENA), U5.16 (ENB)
unnamed: C10.1, R10.1
unnamed: C10.2, U5.4 (VCP)
unnamed: C14.2, D34.1 (K), U5.17 (VBOOT)
unnamed: D1.2 (K), R13.1
unnamed: D2.2 (K), R50.1
unnamed: D3.2 (K), R1.8
unnamed: D4.2 (K), R1.5
unnamed: D5.2 (A), D10.2 (K), R2.1
unnamed: D11.2 (K), R5.1
unnamed: D6.1 (A), D12.1 (K), R6.8
unnamed: D7.1 (A), D13.1 (K), R6.7
unnamed: D8.1 (A), D14.1 (K), R6.6
unnamed: D9.1 (A), D15.1 (K), R6.5
unnamed: D16.1 (A), D20.1 (K), R7.8
unnamed: D17.1 (A), D21.1 (K), R7.7
unnamed: D18.1 (A), D22.1 (K), R7.6
unnamed: D19.1 (A), D23.1 (K), R7.5
unnamed: D26.1 (A), D29.1 (K), R16.7
unnamed: D26.2 (K), D29.2 (A), R14.2
unnamed: D27.1 (A), D30.1 (K), R16.6
unnamed: D27.2 (K), D30.2 (A), R15.2
unnamed: D33.1 (K), D34.2 (A), R10.2
unnamed: G4.1, G4.6, G4.11
unnamed: G4.5, G4.10, G4.15
unnamed: G4.2, G4.7, G4.12
unnamed: G4.3, G4.8, G4.13
unnamed: G4.4, G4.9, G4.14
unnamed: G5.1, G5.6, G5.11
unnamed: G5.5, G5.10, G5.15
unnamed: G5.2, G5.7, G5.12
unnamed: G5.3, G5.8, G5.13
unnamed: G5.4, G5.9, G5.14
unnamed: G6.1, G6.6, G6.11
unnamed: G6.5, G6.10, G6.15
unnamed: G6.2, G6.7, G6.12
unnamed: G6.3, G6.8, G6.13
unnamed: G6.4, G6.9, G6.14
unnamed: G7.1, G7.6, G7.11
unnamed: G7.5, G7.10, G7.15
unnamed: G7.2, G7.7, G7.12
unnamed: G7.3, G7.8, G7.13
unnamed: G7.4, G7.9, G7.14
unnamed: G9.1, G9.6, G9.11
unnamed: G9.5, G9.10, G9.15
unnamed: G9.2, G9.7, G9.12
unnamed: G9.3, G9.8, G9.13
unnamed: G9.4, G9.9, G9.14
unnamed: G11.1, G11.6, G11.11
unnamed: G11.5, G11.10, G11.15
unnamed: G11.2, G11.7, G11.12
unnamed: G11.3, G11.8, G11.13
unnamed: G11.4, G11.9, G11.14
unnamed: G12.1, G12.6, G12.11
unnamed: G12.5, G12.10, G12.15
unnamed: G12.2, G12.7, G12.12
unnamed: G12.3, G12.8, G12.13
unnamed: G12.4, G12.9, G12.14
unnamed: J27.1, M12.W8 (V33_OUT)
unnamed: J27.2, M12.W7 (SWCLK)
unnamed: J27.4, M12.W6 (SWDIO)
unnamed: J27.5, M12.W5 (nReset)
unnamed: M3.N25 (SWCLK), M7.N5 (SWCLK)
unnamed: M3.N26 (SWDIO), M7.N4 (SWDIO)
unnamed: M3.N27 (SWO), M7.N3 (SWO)
unnamed: M8.V2 (CAN_VIO), M12.W2 (CAN_VIO)
unnamed: M8.V6 (CAN_RX), M12.W3 (CAN_RX)
unnamed: M8.V5 (CAN_TX), M12.W4 (CAN_TX)
unnamed: P2.5 (1I), P21.1
unnamed: P2.6 (1K), R34.2
unnamed: P2.20 (1R), R58.2
unnamed: P2.68 (4G), R52.2
unnamed: P2.69 (4I), R22.2
unnamed: P2.74 (4H), R51.2
unnamed: P2.75 (4J), R8.2
unnamed: P2.21 (1T), P16.1
unnamed: P2.10 (1S), P17.1
unnamed: R21.2, R27.2
unnamed: R24.2, R27.1, R48.1
unnamed: R41.2, U6.4 (PG)
unnamed: U3.6 (-), U3.7

Notes on the sheet:
For 1990-1993 A/T and 1994+
Injection
* Warning! Remove R29 is you use TLS115
For 1990-1993
Analog inputs (sensors)
Install R25 for 1990-1993 manual models with KIA TPS Also remove R22 for KIA TPS WARNING: Installing R25 with stock 1990-1993 TP switch will lead to short of 5V-GND!
For 1994+
Not OEM
Ignition
Ouputs
For 1994+
Accelerometer
For 1990-1993 M/T
For 1990-1993
Pull-ups inside MCU
Protected 5V analog power supply for Sensors
Prototype areas
ETB driver
Bus types
LEDs
http://rusefi.com/s/hellenNA6
Board info
Power
General purpose bus
Remove for KIA resistive TP Sensor
Baro pressure sensor
Discrete inputs
Reverse-polarity + transient protection (MX-5 fork). Ideal diode on 1B ahead of fuses F1-F3; bidirectional TVS on the input. See bom_replace for D418/U420/D420/F410 changes.
Coil-on-plug (MX-5 fork): IGN3 and IGN4 come out on solder pads P24 / P25 (next to the ign8 module). For a COP harness, link them with insulated wire inside the case to the spare-cavity pads P16 (1T) and P15 (1U). 1T / 1U are empty cavities on non-US manual 94-95 cars.

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
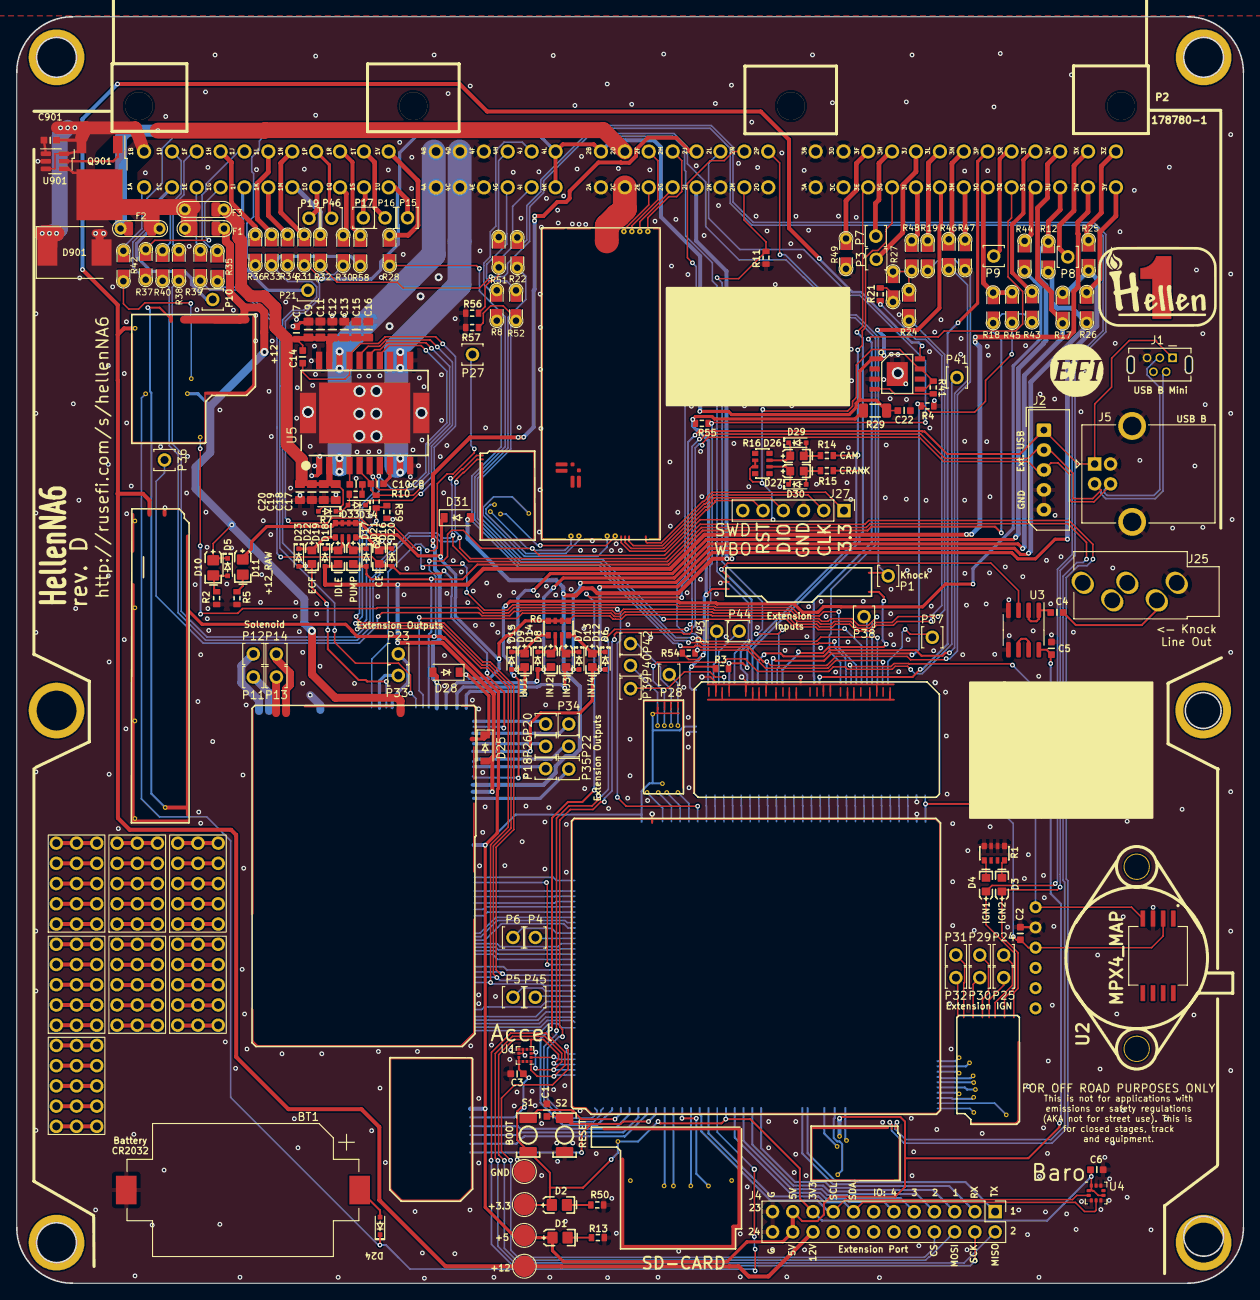
[picture p10: board hellen64_NA6_94.kicad_pcb from above]

Board: 2 copper layers, 154.0 x 159.0 mm, 213 parts (1 on the bottom side), 295 nets.
