donegal06/mx5-na8-ecu/(commit log)

2026-11-13 Harden 12 V input via BOM replacements (no layout change)
    From the fault simulations (ISO 16750-2 / ISO 7637-2 style pulses):
    - U420 LMR14030 (40 V) -> LMR16030SDDA (60 V): pin-compatible SO-8
    PowerPAD, same 0.75 V FB reference and RT curve, so the existing
    68k/12k divider (5.0 V) and 10k RT (~2.2 MHz) are unchanged.
    - D420 SS34 (40 V) -> SS310 (100 V) catch diode, needed with the 60 V buck.
    - D418 SMCJ30A -> SMCJ33A: VBR min 36.7 V no longer conducts against an
    alternator clamped at 35 V (SMCJ30A at its 33.3 V minimum absorbed
    ~11 J in that case). Vc max 53.3 V stays inside the 60 V buck rating.
    - F410 0.5 A / 24 V PTC -> 0 ohm: logic feed draws ~0.52 A during a
    6.5 V crank, abov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
    [bom_replace_hellen64_NA6_94-d.csv]
2026-11-13 CI: push generated board files back to the branch that was built
    The workflow referenced steps.extract_branch, which doesn't exist, so the
    push action always targeted main and was rejected for branch builds.
    Use github.ref_name, and skip the push on pull_request events.
    Claude-Session: https://claude.ai/code/session_01KmKUwZCxxcLmP1BuYthJs7
2026-11-13 [skip actions] Auto-generated board
    [hellen64_NA6_94-d-BOM.csv]
2026-11-13 Igniter drive: 330 ohm series resistors on IGN1/IGN2 (1G/1H)
    R467 (IGN1 -> 1G) and R464 (IGN2 -> 1H) in the ign8 module go from
    10 ohm to 330 ohm, the series value the MegaSquirt community uses with
    the factory NA igniters. Limits a short to battery on the igniter wires
    to ~39 mA (LVC4245 abs max ~50 mA); the 0603 is the sacrificial part in
    a sustained short. IGN3-8 unchanged for future smart coils.
    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
    [bom_replace_hellen64_NA6_94-d.csv]
2026-11-13 Schematic: ideal-diode reverse-polarity stage on 1B ahead of F1-F3
    Adds, left of connector unit 1:
    - U901 LM74700QDBVRQ1 ideal-diode controller (C2941042), EN tied to
    ANODE (always on), C901 100n VCAP-ANODE (C14663)
    - Q901 NCEP078N10AK 100 V N-MOSFET, TO-252 (C2686699): source = 1B,
    drain = 1B_PROT
    - D901 SMCJ33CA bidirectional TVS on 1B (C699040)
    The connector wire to the fuses is split: connector side stays 1B, fuse
    side becomes 1B_PROT, and the F2 (wideband heater) label is renamed to
    1B_PROT, so all three fuses sit behind the ideal diode. Fault sims: with
    this stage a reversed battery draws ~0 A (was ~265 A through the SMCJ),
    and ISO 7637-2 pulse 1 puts ~48 V across the blocking FET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
    [hellen64_NA6_94.kicad_sch]
2026-11-13 COP option links IGN3->1T / IGN4->1U; single 120R CAN termination
    - R902/R903 (0805 link, Hellen Jumper-Pad-Pad footprint) route OUT_IGN3 to
    connector 1T and OUT_IGN4 to 1U for a future coil-on-plug harness. Both are
    empty cavities on non-US manual 94-95 cars. Not fitted by default via
    bom_replace, so the stock build is unchanged.
    - Name the 1T net (P16 pad wire) so the link has a target.
    - Drop R430_2: both CAN modules carried 120R on the same bus (60R on board).
    ECU end is now 120R; the last gauge pod terminates the far end.
    - tools/add_cop_jumpers.py: the scripted schematic edit.
    Claude-Session: https://claude.ai/code/sessio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
    [bom_replace_hellen64_NA6_94-d.csv, hellen64_NA6_94.kicad_sch]
2026-11-13 PCB: place and route the reverse-polarity stage; drop R902/R903
    Layout (tools/layout_rp_stage.py, checked with tools/verify_rp_layout.py):
    - U901/Q901/D901/C901 added to the PCB, linked to their schematic symbols,
    with nets /1B_PROT, /RP_GATE, /RP_VCAP; F1.1, F2.2, F3.1 now on /1B_PROT.
    - Placed in the free strip left of the connector, below mounting hole J11
    (above the pins is under the connector body).
    - Pin 1B -> D901 -> Q901 source (2 mm); Q901 tab -> F1/F2/F3 inputs (2 mm);
    gate, anode, cathode, EN and VCAP links around U901; GND vias.
    - 2D (wideband heater feed) loop moved to B.Cu, ending on F2's pad-1 hole;
    the +12V run at X 29.35 moved to B.Cu; three GND stitching vias remove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
    [bom_replace_hellen64_NA6_94-d.csv, hellen64_NA6_94.kicad_pcb, hellen64_NA6_94.kicad_sch]
2026-11-13 Frame exports: KiCad 10 gerbers + drill with the reverse-polarity stage
    - Gerbers re-plotted from KiCad 10.0.8 with the board's saved plot settings
    (aux origin, Protel extensions, no aperture macros, no X2). Outline and
    origin match the 2022 export; new pads/vias/tracks present.
    - Drill: KiCad 10 wrote METRIC/decimal with routed slots, which gerbmerge
    rejects (MeasurementUnits = inch). Converted to the previous format
    (INCH,TZ 2:4, G85 slots) with tools/drl_metric_to_inch.py. Hole-by-hole
    vs the old file: only the 3 removed GND vias and the 7 new vias differ;
    slots identical.
    - BOM/CPL: U901, Q901, D901, C901 appended (positions from the PCB,
    aux-origin relative, rotations as K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
    [hellen64_NA6_94-B_Cu.gbl, hellen64_NA6_94-B_Fab.gbr, hellen64_NA6_94-B_Mask.gbs, hellen64_NA6_94-B_Silkscreen.gbo, hellen64_NA6_94-Edge_Cuts.gm1, hellen64_NA6_94-F_Cu.gtl, hellen64_NA6_94-F_Fab.gbr, hellen64_NA6_94-F_Mask.gts]
2026-11-13 C901 value "100n 50V" -> "100n" to match the other C14663 rows
    CI BOM post-processing merges rows by LCSC part number and aborts on a
    comment mismatch ("100n" != "100n 50V"). C14663 is already the 50 V
    0603 X7R part, so the shorter value is accurate. Updated in the schematic,
    the PCB value field and the frame BOM/CPL so all four stay in parity.
    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
    [hellen64_NA6_94.csv, hellen64_NA6_94.kicad_pcb, hellen64_NA6_94.kicad_sch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]
2026-11-13 Layout v2: reverse-polarity stage inside the case keep-clear line [skip actions]
    The silkscreen outline near the board edge is the case keep-clear line;
    Hellen puts no parts, tracks or vias outside it. v1 had D901 and some
    /1B copper in that strip, so the stage is re-placed and re-routed:
    - U901/C901 to the left of Q901, Q901 rotated with leads up (S to the
    1B feed, G to RP_GATE), D901 below with its 1B pad fed on both layers
    - /2D re-routed F2.1 -> P2.32 round the stage; +12V spine moved to B.Cu
    - removed two duplicate USB vias that DRC flagged
    - rusEFI URL silkscreen shrunk to 1.5 mm and moved clear of Q901/D901
    - schematic: LM74700 pin rows swapped so GATE/CATHODE labels no longer
    ov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
    [hellen64_NA6_94.kicad_pcb, hellen64_NA6_94.kicad_sch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]
2026-11-13 Re-plot gerbers and drill for layout v2
    KiCad 10 plots of the v2 board. The drill came out as inch/decimal with
    routed slots, so drl_metric_to_inch.py now accepts inch input as well
    and writes the INCH,TZ 2:4 + G85 format gerbmerge needs.
    Checked against the previous plot: the only drill changes are the 5
    vias removed and 9 added by v2 (plus the two duplicate USB vias gone);
    copper, mask, paste and silk differences sit only in the reverse-
    polarity area and the moved URL text. In the new copper every new net
    is its own island, clear of the ground pour (zones were refilled).
    tools/gerb_render.py is the small rasteriser used for that check.
    The schematic PDF is still the 2022 export.
    Co-Aut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
    [hellen64_NA6_94-B_Cu.gbl, hellen64_NA6_94-B_Fab.gbr, hellen64_NA6_94-B_Mask.gbs, hellen64_NA6_94-B_Silkscreen.gbo, hellen64_NA6_94-Edge_Cuts.gm1, hellen64_NA6_94-F_Cu.gtl, hellen64_NA6_94-F_Fab.gbr, hellen64_NA6_94-F_Mask.gts]
2026-11-13 Fit the on-board wideband: U602 STM32F042K6T6 and Q600 BTS3028SDL
    rusEFI left the wbo module's MCU and heater switch out of the JLC
    assembly. Both are JLC/LCSC parts now (C69216, C2150071), so fit them.
    Q601 (the through-hole alternative to Q600) stays unfitted.
    The STM32 needs a one-time SWD flash with the wideband bootloader image
    through header J27; after that rusEFI updates it over CAN.
    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
    [bom_replace_hellen64_NA6_94-d.csv]
2026-11-13 Drop the U601_2 row from the BOM replacements
    There is no U601_2 on this board (one wideband module), but the replace
    row put it into the JLC BOM with no matching placement, which JLC's
    upload would flag.
    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
    [bom_replace_hellen64_NA6_94-d.csv]
2026-11-13 Have JLC fit the main ECU connector P2 (TE 178780-1, C5166246)
    76-pin through-hole header; Hellen leaves it for hand soldering. It is
    an LCSC part, so put it in the assembly BOM. The connector's pegs only
    let it go in one way round.
    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
    [bom_replace_hellen64_NA6_94-d.csv]
2026-11-14 Leave the optional high-side/push-pull/solenoid outputs unfitted
    U300/U303 (RZ7899) and Q300-Q304, Q313, Q314 (PJM2319PSA) only drive
    the spare outputs on solder pads P11-P14, P18, P22, P23, P26 and P27;
    none of them reach the ECU connector and nothing in the NA8 plan uses
    them. Neither part can be ordered through JLC at the moment, so mark
    them not fitted. They can be hand-fitted later if a pad output is
    ever needed.
    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
    [bom_replace_hellen64_NA6_94-d.csv]
2026-11-14 Use in-stock equivalents for C603 and the indicator LEDs
    C603 33n 0402 -> C106862 (50 V X7R); blue LEDs -> C138541; green ->
    C19273151; yellow -> C165981. Picked on JLC's parts page because the
    originals had no JLC stock; same size, value and forward voltage.
    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
    [bom_replace_hellen64_NA6_94-d.csv]
2026-11-14 C227-C229 2.2u 0805 -> C125847 (50 V X7R, in stock)
    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
    [bom_replace_hellen64_NA6_94-d.csv]
2026-11-14 Add an essential-build JLC parts list (no on-board wideband, ETB driver or SD card)
    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
    [hellen64_NA6_94-d-BOM-essential.csv, hellen64_NA6_94-d-BOM-full.csv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]
